lieninghzc/Project_U585_QS/Core/Src/main.c

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
/* Includes ------------------------------------------------------------------*/
#include "main.h"
#include "i2c.h"
#include "icache.h"
#include "tim.h"
#include "usart.h"
#include "gpio.h"

/* USER CODE BEGIN Includes */
#include "OLED.h"
#include "TSEN.h"
#include "Heating.h"
#include "ENCODER.h"
#include "LSEN.h"
#include "SENS.h"
#include "i2c.h"
#include "VOICE.h"
#include "Wet.h"
#include "LED.h"
#include "DISPLAY.h"
#include "MENU.h"
#include "FLASH_EEPROM.h"
/* USER CODE END Includes */


void SystemClock_Config (void);

/* USER CODE BEGIN 0 */

/**
  * @brief  低功耗延时: 替代 HAL_Delay, CPU 在中断等待期间进入 Sleep 模式。
  *         Sleep 模式下 CPU 时钟门控关闭，所有外设 (I2C/TIM/UART/GPIO)
  *         及 SysTick 继续运行。任何 IRQ 唤醒 CPU 后检查计时，
  *         未到时则再次 __WFI() 休眠。
  * @param  ms: 延时毫秒数
  * @note   与 HAL_Delay(ms) 功能完全等价, 零行为差异。
  *         U585 Sleep 模式相比全速忙等可节省约 50%+ 的动态功耗。
  */
static void SleepDelay(uint32_t ms)
{
    uint32_t tickstart = HAL_GetTick();
    while ((HAL_GetTick() - tickstart) < ms)
    {
        /* SLEEPDEEP=0 → Sleep 模式 (非 Stop)。
         * CPU 时钟停, HCLK/PCLK 不停, SysTick 每 1ms 唤醒 CPU。
         * Flash 在 Sleep 期间自动断电 (由 LowPower_Init 配置)。 */
        __WFI();
    }
}

/* USER CODE END 0 */

/**
  * @brief  The application entry point.
  * @retval int
  */
int main (void)
{
    /* MCU Configuration--------------------------------------------------------*/

    /* Reset of all peripherals, Initializes the Flash interface and the Systick. */
    HAL_Init();

    /* Configure the system clock */
    SystemClock_Config();

    /* USER CODE BEGIN SysInit */

    /* U585 低功耗初始化: Flash 在 Sleep 时自动断电 (STOP 模式下自动恢复) */
    __HAL_FLASH_SLEEP_POWERDOWN_ENABLE();

    /* USER CODE END SysInit */

    /* Initialize all configured peripherals */
    MX_GPIO_Init();
    MX_ICACHE_Init();
    MX_I2C1_Init();
    MX_TIM3_Init();
    MX_TIM4_Init();
    MX_UART4_Init();
    /* USER CODE BEGIN 2 */
    SENS_Init();
    Heating_Init();
    DISPLAY_Init();  // OLED 初始化 + 启动画面

    Heating_Set(25.0f);

    LED_Init();             // LED PWM 初始化
    LED_SetTargetLux(1000);  // 设定目标照度 1000 lux

    MENU_Init();   // 菜单初始化 (PB5 按键)

    VOICE_Init();  // 语音模块初始化 (UART4 中断接收模式)

    FlashEE_Init(); // 从 Flash 恢复上次断电前保存的配置 (温度/湿度/光照/模式)
                   /* USER CODE END 2 */

    /* Infinite loop */
    /* USER CODE BEGIN WHILE */

    //HAL_GPIO_WritePin(GPIOA, GPIO_PIN_4, GPIO_PIN_RESET);    // 拉低 CS
    while (1)
    {
        SENS_Read();

        /* 温控 */
        Heating_Control(temperature_c);

        /* 湿控 */
        Wet_Control(humidity);

        /* LED 自动调光 */
        LED_Task();

        /* OLED 显示刷新 (含阴影缓存, 仅更新变化字符) */
        DISPLAY_Update();

        /* 菜单任务 (按键/编码器检测 + 休眠管理) */
        MENU_Task();

        /* 语音指令处理 (非阻塞, 每 ~300ms 自动轮询 ASRPRO) */
        VOICE_Process();

        /* Flash EEPROM 后台写入 (dirty 3 秒后自动保存) */
        FlashEE_Task();

        SleepDelay(100); /* 低功耗延时: CPU Sleep 替代忙等, 零行为差异 */
        /* USER CODE END WHILE */

        /* USER CODE BEGIN 3 */
    }
    /* USER CODE END 3 */
}

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
