lieninghzc/Project_U585_QS/project_U585_QS.ioc

Mcu.UserName=STM32U585CIUx
PA0.Signal=UART4_TX
PA1.Signal=UART4_RX
PA10.Signal=CRS_SYNC
PA3.Signal=GPIO_Output
PA6.Signal=S_TIM3_CH1
PA7.Signal=S_TIM3_CH2
PA8.Signal=RCC_MCO
PB0.GPIO_Label=Heating
PB0.Signal=GPIO_Output
PB1.GPIO_Label=Wet
PB1.Signal=GPIO_Output
PB12.Signal=GPIO_Output
PB13.Signal=GPIO_Output
PB6.Signal=I2C1_SCL
PB7.GPIO_Label=LED
PB7.Signal=S_TIM4_CH2
PC13.Signal=GPIO_Output
