lieninghzc/Project_U585_QS/Core/Inc/main.h

#define Heating_Pin GPIO_PIN_0
#define Heating_GPIO_Port GPIOB
#define Wet_Pin GPIO_PIN_1
#define Wet_GPIO_Port GPIOB
#define LED_Pin GPIO_PIN_7
#define LED_GPIO_Port GPIOB
