lieninghzc/Project_U585_QS/(commit log)

2026-05-30 Initial commit: STM32U585 project
2026-05-30 GIT修改测试1
2026-05-30 温湿度传感器封装
2026-06-05 旋转编码器封装
2026-06-05 编码器+温湿度封装完成
2026-06-05 亮度+编码器+温湿度封装
2026-06-05 亮编温湿合并封装
2026-06-09 温湿度负反馈
2026-06-17 语音模块初步配置尝试
2026-06-17 语音模块配置尝试2
2026-06-26 LED+完整语音控制
2026-07-04 最终版1
